wardnb/ego-coil/docs/README.md

# docs/

| File | Read it when |
|---|---|
| `build-guide.md` | You're building one. Start here. |
| `bom.md` | Ordering parts. |
| `design.md` | You want to know *why*, or you're changing something. §6 is safety. |
| `dock-measurement.md` | Fitting the EGO dock to your pack. |
| `schematic.svg` | Generated by `tools/draw_schematic.py`. |
| `images/` | Renders used by the READMEs. |
