wardnb/ego-coil/docs/images/body.png

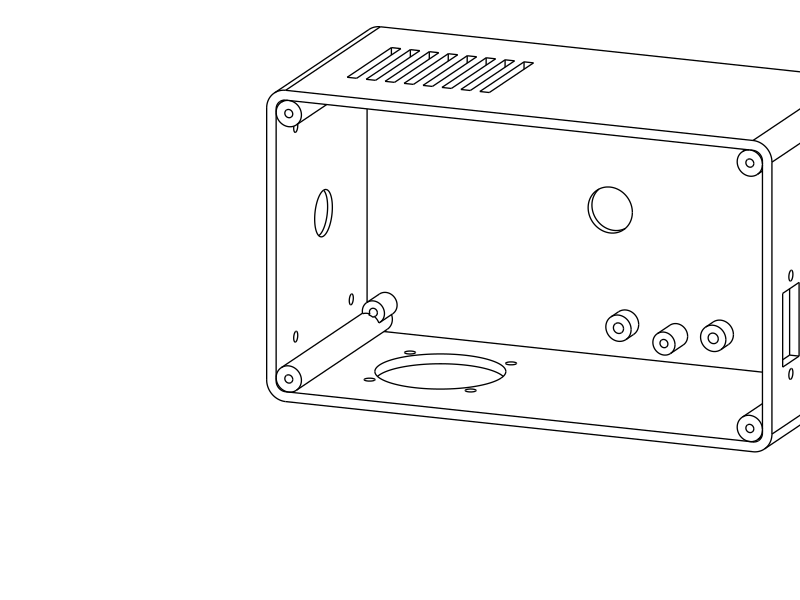
docs/images/body.png
