wardnb/ego-coil/docs/images/dock-heightmap.png

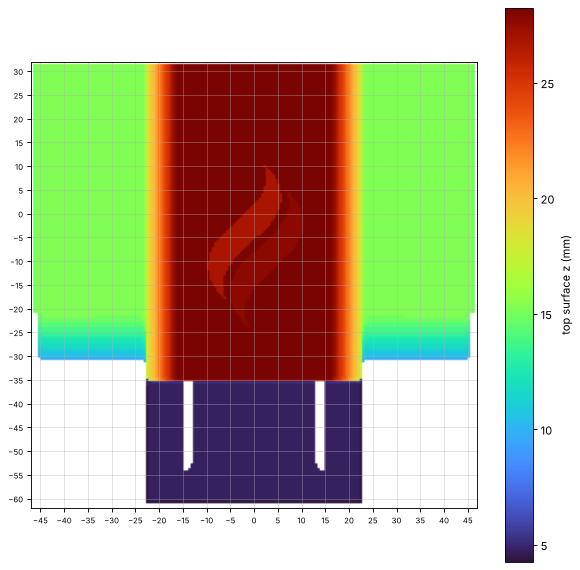
docs/images/dock-heightmap.png
