wardnb/ego-coil/docs/images/head.png

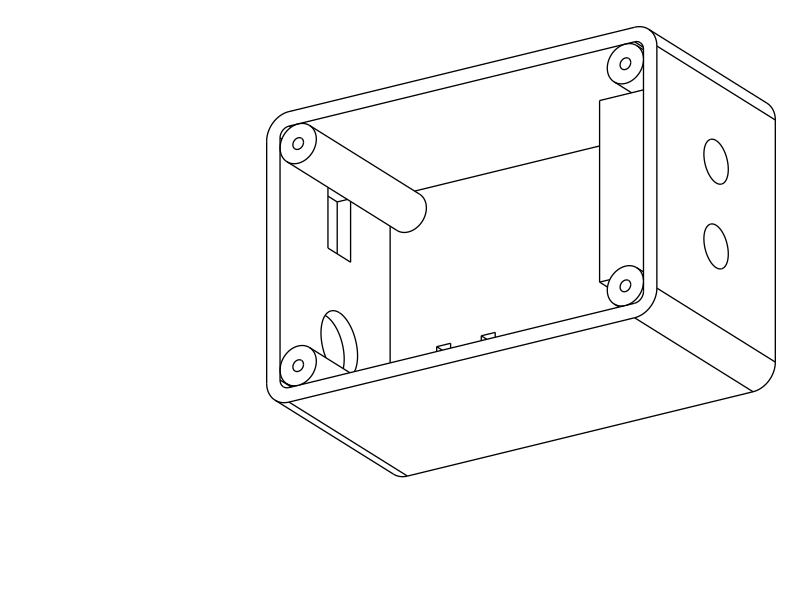
docs/images/head.png
