wardnb/ego-coil/docs/images/pcb-placement.png

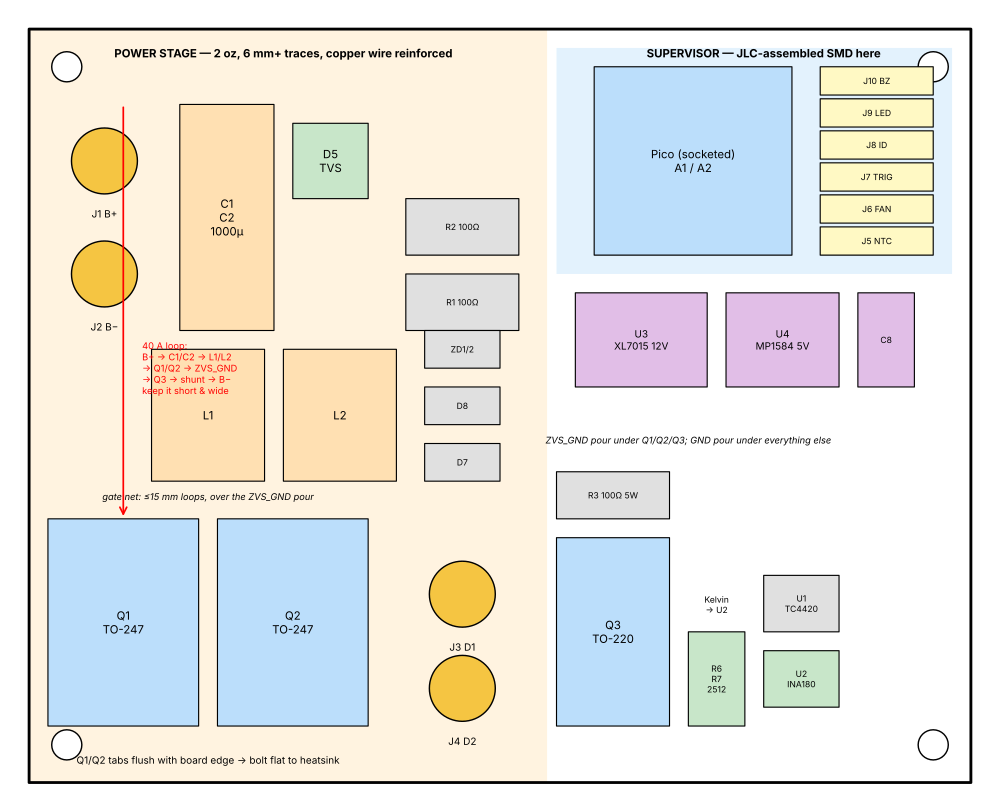
docs/images/pcb-placement.png
