wardnb/ego-coil/pcb/bom.csv

Ref | Value | Footprint | Assembly | LCSC | Description
C10 | 1uF | Capacitor_SMD:C_0805_2012Metric | SMT |  | TC4420 decoupling, close to pin 8
C3 | 1uF/100V | Capacitor_SMD:C_1210_3225Metric | SMT |  | X7R 100 V bypass at choke feed
C4 | 1uF/100V | Capacitor_SMD:C_1210_3225Metric | SMT |  | X7R 100 V bypass at choke feed
C5 | 100nF | Capacitor_SMD:C_0603_1608Metric | SMT |  | INA180 decoupling
C6 | 10nF | Capacitor_SMD:C_0603_1608Metric | SMT |  | ISENSE filter (with trace R≈1k) ~16 kHz
C7 | 100nF | Capacitor_SMD:C_0603_1608Metric | SMT |  | VSENSE filter
C9 | 10uF | Capacitor_SMD:C_0805_2012Metric | SMT |  | +5 V bulk
D5 | SMCJ70A | Diode_SMD:D_SMC | SMT |  | TVS 70 V standoff, SMC
D6 | 1N4148W | Diode_SMD:D_SOD-123 | SMT |  | Fan flyback
Q4 | 2N7002 | Package_TO_SOT_SMD:SOT-23 | SMT |  | Fan low-side switch
R10 | 5.6k | Resistor_SMD:R_0805_2012Metric | SMT |  | V_pack divider bottom, 1 %
R11 | 10k | Resistor_SMD:R_0805_2012Metric | SMT |  | NTC pull-up to 3V3, 1 %
R12 | 10k | Resistor_SMD:R_0805_2012Metric | SMT |  | EN pull-down: stage off while Pico boots
R13 | 1k | Resistor_SMD:R_0805_2012Metric | SMT |  | Fan gate
R14 | 330R | Resistor_SMD:R_0805_2012Metric | SMT |  | LED series
R15 | 330R | Resistor_SMD:R_0805_2012Metric | SMT |  | LED series
R16 | 330R | Resistor_SMD:R_0805_2012Metric | SMT |  | LED series
R17 | 10k | Resistor_SMD:R_0805_2012Metric | SMT |  | Gate-source hold-off
R18 | 10k | Resistor_SMD:R_0805_2012Metric | SMT |  | Gate-source hold-off
R4 | 10R | Resistor_SMD:R_0805_2012Metric | SMT |  | Q3 gate resistor
R5 | 10k | Resistor_SMD:R_0805_2012Metric | SMT |  | Q3 gate pull-down
R6 | 2mR/3W | Resistor_SMD:R_2512_6332Metric | SMT |  | Shunt, metal strip 2512 3 W
R7 | 2mR/3W | Resistor_SMD:R_2512_6332Metric | SMT |  | Shunt, metal strip 2512 3 W
R8 | 1k | Resistor_SMD:R_0805_2012Metric | SMT |  | ISENSE series / filter
R9 | 100k | Resistor_SMD:R_0805_2012Metric | SMT |  | V_pack divider top, 1 %
U2 | INA180A2 | Package_TO_SOT_SMD:SOT-23-5 | SMT |  | Current-sense amp, gain 50 → 50 mV/A with 1 mΩ
A1 | HDR20 | Connector_PinSocket_2.54mm:PinSocket_1x20_P2.54mm_Vertical | THT |  | Pico socket, pins 1–20
A2 | HDR20 | Connector_PinSocket_2.54mm:PinSocket_1x20_P2.54mm_Vertical | THT |  | Pico socket, pins 21–40
C1 | 1000uF/100V | Capacitor_THT:CP_Radial_D18.0mm_P7.50mm | THT |  | Bulk electrolytic, low ESR
C2 | 1000uF/100V | Capacitor_THT:CP_Radial_D18.0mm_P7.50mm | THT |  | Bulk electrolytic, low ESR
C8 | 100uF/25V | Capacitor_THT:CP_Radial_D6.3mm_P2.50mm | THT |  | +12 V rail bulk
D7 | UF4007 | Diode_THT:D_DO-41_SOD81_P10.16mm_Horizontal | THT |  | Gate→opposite drain feedback
D8 | UF4007 | Diode_THT:D_DO-41_SOD81_P10.16mm_Horizontal | THT |  | Gate→opposite drain feedback
H1 | M3 | MountingHole:MountingHole_3.2mm_M3 | THT |  | M3 standoff
H2 | M3 | MountingHole:MountingHole_3.2mm_M3 | THT |  | M3 standoff
H3 | M3 | MountingHole:MountingHole_3.2mm_M3 | THT |  | M3 standoff
H4 | M3 | MountingHole:MountingHole_3.2mm_M3 | THT |  | M3 standoff
J1 | M4 | MountingHole:MountingHole_4.3mm_M4_Pad | THT |  | Pack B+ (from inline 40 A fuse), ring terminal, 10 AWG
J10 | HDR2 | Connector_JST:JST_XH_B2B-XH-A_1x02_P2.50mm_Vertical | THT |  | Piezo buzzer, JST-XH 2p
J2 | M4 | MountingHole:MountingHole_4.3mm_M4_Pad | THT |  | Pack B−, ring terminal, 10 AWG
J3 | M4 | MountingHole:MountingHole_4.3mm_M4_Pad | THT |  | Lead to XT90 pin 1 (D1), 10 AWG
J4 | M4 | MountingHole:MountingHole_4.3mm_M4_Pad | THT |  | Lead to XT90 pin 2 (D2), 10 AWG
J5 | HDR2 | Connector_JST:JST_XH_B2B-XH-A_1x02_P2.50mm_Vertical | THT |  | NTC 10 k B3950 on heatsink, JST-XH 2p
J6 | HDR2 | Connector_JST:JST_XH_B2B-XH-A_1x02_P2.50mm_Vertical | THT |  | Fan 12 V, JST-XH 2p (+12 V, FAN_N)
J7 | HDR2 | Connector_JST:JST_XH_B2B-XH-A_1x02_P2.50mm_Vertical | THT |  | Trigger, JST-XH 2p
J8 | HDR3 | Connector_JST:JST_XH_B3B-XH-A_1x03_P2.50mm_Vertical | THT |  | Head ID, JST-XH 3p (ID0, ID1, GND) → panel
J9 | HDR4 | Connector_JST:JST_XH_B4B-XH-A_1x04_P2.50mm_Vertical | THT |  | RGB LED common cathode (R, G, B, GND), JST-XH 4p
L1 | 47uH/20A | Inductor_THT:L_Toroid_Horizontal_D28.0mm_P30.00mm_Fastron_DSP | THT |  | Choke, 30 t 14 AWG on sendust toroid (ADJUST footprint)
L2 | 47uH/20A | Inductor_THT:L_Toroid_Horizontal_D28.0mm_P30.00mm_Fastron_DSP | THT |  | Choke, 30 t 14 AWG on sendust toroid (ADJUST footprint)
Q1 | IRFP4332 | Package_TO_SOT_THT:TO-247-3_Vertical | THT |  | 250 V 57 A, heatsink, Mouser only
Q2 | IRFP4332 | Package_TO_SOT_THT:TO-247-3_Vertical | THT |  | 250 V 57 A, heatsink, Mouser only
Q3 | IRFB4110 | Package_TO_SOT_THT:TO-220-3_Vertical | THT |  | 100 V 4.5 mΩ burst switch, small heatsink
R1 | 100R/3W | Resistor_THT:R_Axial_DIN0918_L18.0mm_D6.0mm_P22.86mm_Horizontal | THT |  | Gate pull-up from +12 V, wirewound 3 W
R2 | 100R/3W | Resistor_THT:R_Axial_DIN0918_L18.0mm_D6.0mm_P22.86mm_Horizontal | THT |  | Gate pull-up from +12 V, wirewound 3 W
R3 | 100R/5W | Resistor_THT:R_Axial_Power_L20.0mm_W6.4mm_P25.40mm | THT |  | Bulk-cap pre-charge across Q3
U1 | TC4420CPA | Package_DIP:DIP-8_W7.62mm | THT |  | 6 A MOSFET driver, TTL input
U3 | HDR4 | Connector_PinHeader_2.54mm:PinHeader_1x04_P2.54mm_Vertical | THT |  | XL7015 buck module 5–80 V → 12 V (IN+ IN- OUT+ OUT-)
U4 | HDR4 | Connector_PinHeader_2.54mm:PinHeader_1x04_P2.54mm_Vertical | THT |  | MP1584 buck module 12 → 5 V (IN+ IN- OUT+ OUT-)
ZD1 | 15V/1.3W | Diode_THT:D_DO-41_SOD81_P10.16mm_Horizontal | THT |  | Gate zener clamp
ZD2 | 15V/1.3W | Diode_THT:D_DO-41_SOD81_P10.16mm_Horizontal | THT |  | Gate zener clamp
