wardnb/ego-coil/cad/ego56v_dock.stl

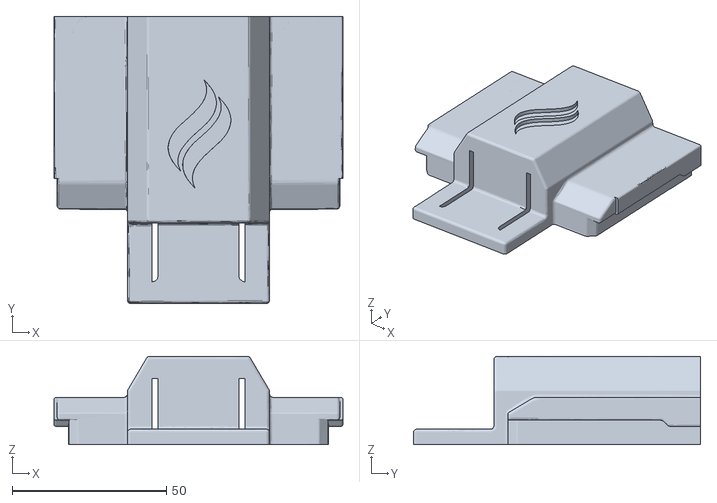
[picture p10: CAD file, 2026-10-26]
cad/ego56v_dock.stl
93.5 x 92.9 x 28.5
