wardnb/ego-coil/cad/out/body.stl

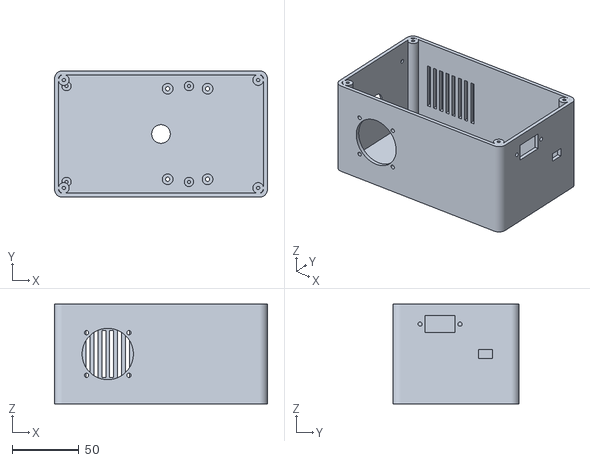
[picture p11: CAD file, 2026-10-26]
cad/out/body.stl
160.0 x 95.0 x 75.0
