wardnb/ego-coil/cad/out/dock.stl

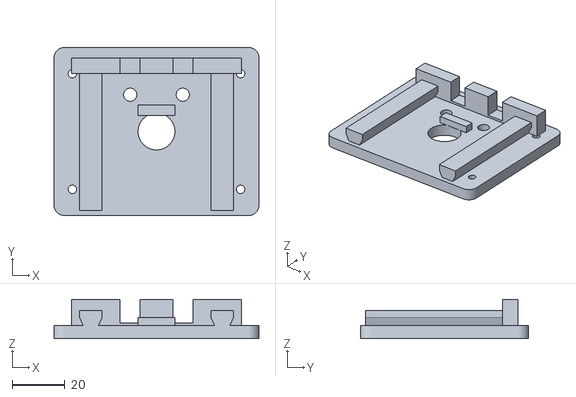
[picture p12: CAD file, 2026-10-26]
cad/out/dock.stl
78.0 x 64.0 x 15.0
