wardnb/ego-coil/cad/out/head.stl

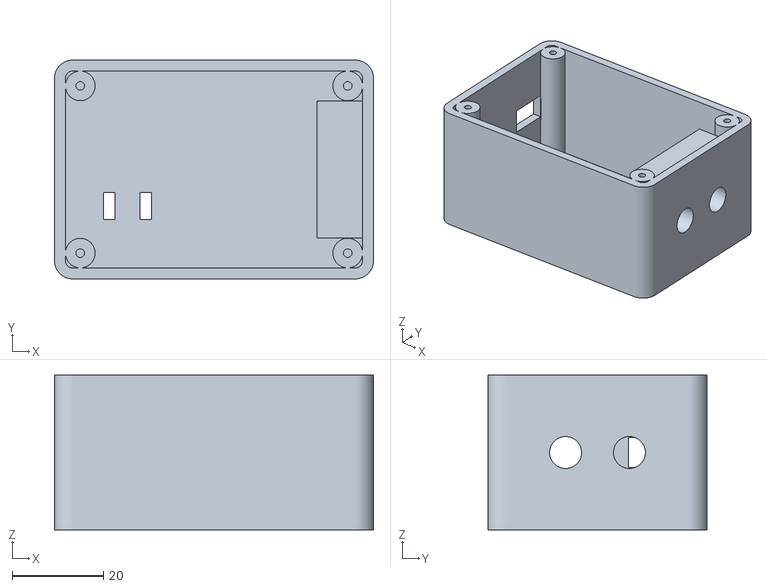
[picture p13: CAD file, 2026-10-26]
cad/out/head.stl
70.0 x 48.0 x 34.0
