wardnb/ego-coil/cad/out/head_lid.stl

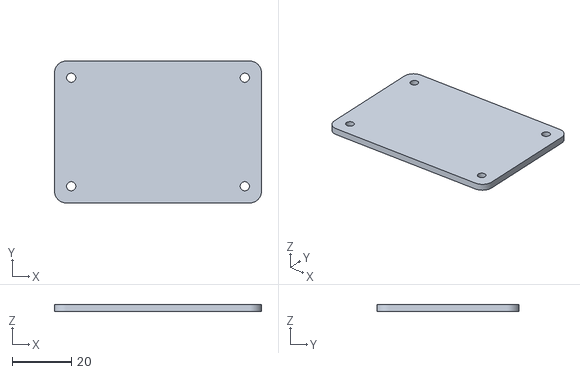
[picture p14: CAD file, 2026-10-26]
cad/out/head_lid.stl
70.0 x 48.0 x 2.40
