wardnb/ego-coil/cad/out/body_lid.stl

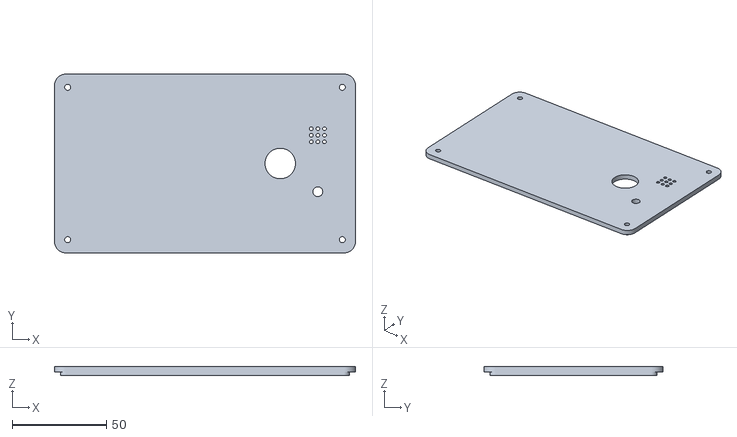
[picture p15: CAD file, 2026-10-26]
cad/out/body_lid.stl
160.0 x 95.0 x 5.00
