wardnb/ego-coil/(commit log)

2026-10-26 Initial design: ZVS induction bolt heater on an EGO 56 V pack
    Design docs, BOM, schematic (schemdraw), tank calculator, RP2040
    supervisor firmware (MicroPython), and parametric CadQuery enclosure
    for the body and swappable coil heads.
    Claude-Session: https://claude.ai/code/session_01NxM5UjbDay4MzUmrHQKbdG
    [body.stl, body_lid.stl, head.stl, head_lid.stl]
2026-10-26 Budget build under $100: shunt current sense, XL7015 supply, CBB81 caps
    - BOM reworked into Budget (~$86) and Reference (~$185) columns
    - Current sense: 2 mOhm shunt + INA180A1 replaces ACS758 (Hall kept as
    a config.py option)
    - 12 V rail: XL7015 80 V buck module; 5 V from an MP1584
    - Cap bank: 5 x 0.33 uF 1200 V CBB81 or salvaged induction-cooktop caps
    - Schematic and firmware updated to match
    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
    [config.py, main.py]
2026-10-26 Printed EGO dock: parametric rails, terminal slots, latch catch + measurement sheet
    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
    [body.stl, dock.stl]
2026-10-26 Use supplied EGO interface STL as the dock, mounted under the body
    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
    [body.stl, ego56v_dock.stl]
2026-10-26 Main PCB (SKiDL netlist, JLC assembly BOM, placement plan), build guide, project page, licence
    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
    [body.stl, bom.csv]
2026-10-26 Assembled-unit mock-up renders for the project page
    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
2026-10-26 Move XT90 to the top of the front face, clear of the hand; re-render
    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
    [body.stl]
